Kytezign/USBKVM/mcad/enclosure.FCStd

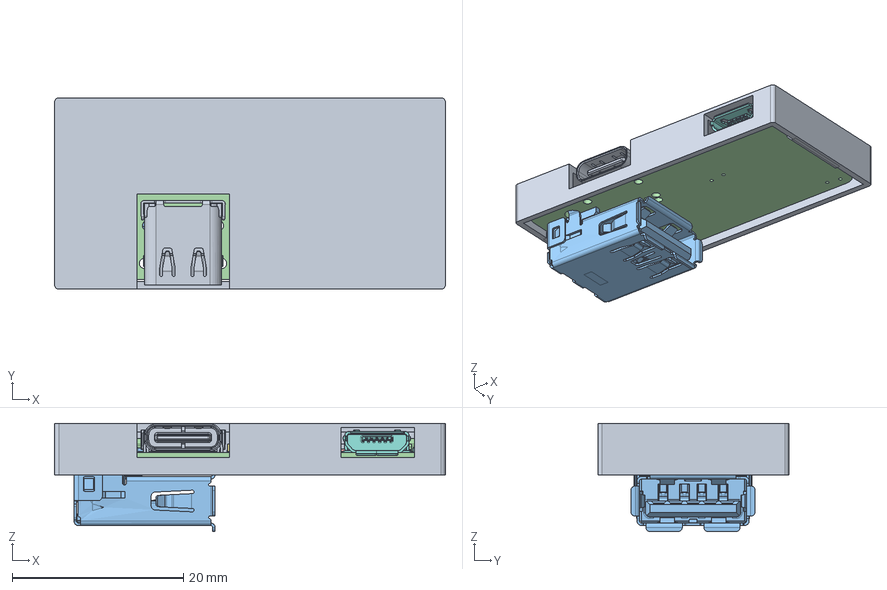
[picture p1: CAD file, 2025-02-08]
mcad/enclosure.FCStd
45.6 x 22.3 x 12.6 mm
ABM8-272-T3
C_0402_1005Metric
C_0402_1005Metric002
C_0402_1005Metric004
C_0402_1005Metric006
QFN_56_1EP_7x7mm_P04mm_EP32x32mm
C_0402_1005Metric008
C_0402_1005Metric010
R_0402_1005Metric
C_0402_1005Metric012
R_0402_1005Metric002
C_0402_1005Metric014
R_0402_1005Metric004
C_0402_1005Metric016
R_0402_1005Metric006
R_0402_1005Metric008
C_0402_1005Metric018
SOT_23_5
R_0402_1005Metric010
C_0402_1005Metric020
R_0402_1005Metric012
C_0402_1005Metric022
C_0402_1005Metric024
C_0402_1005Metric026
C_0402_1005Metric028
R_0402_1005Metric014
R_0402_1005Metric016
C_0402_1005Metric030
R_0402_1005Metric018
C_0402_1005Metric032
QFN_56_1EP_7x7mm_P04mm_EP32x32mm001
C_0402_1005Metric034
C_0402_1005Metric036
SOIC-8-1EP_3.9x4.9mm_P1.27mm_EP2.29x3mm
R_0402_1005Metric020
C_0402_1005Metric038
SOIC-8-1EP_3.9x4.9mm_P1.27mm_EP2.29x3mm002
R_0402_1005Metric022
USB4056-03-A
R_0402_1005Metric024
USB-A3-S-RA
usb_kvm_PCB
