Kytezign/USBKVM/mcad/enclosure-Fusion002.3mf

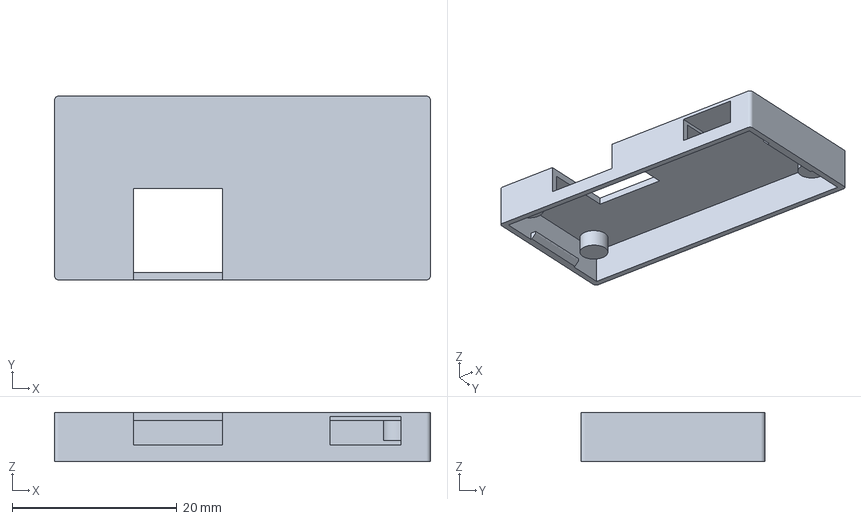
[picture p2: CAD file, 2025-02-08]
mcad/enclosure-Fusion002.3mf
45.6 x 22.3 x 6.00 mm
