Kytezign/USBKVM/ecad/usbkvm/usb_kvm.kicad_pcb

## KiCad design ecad/usbkvm/usb_kvm.kicad_pcb (2025-02-08)

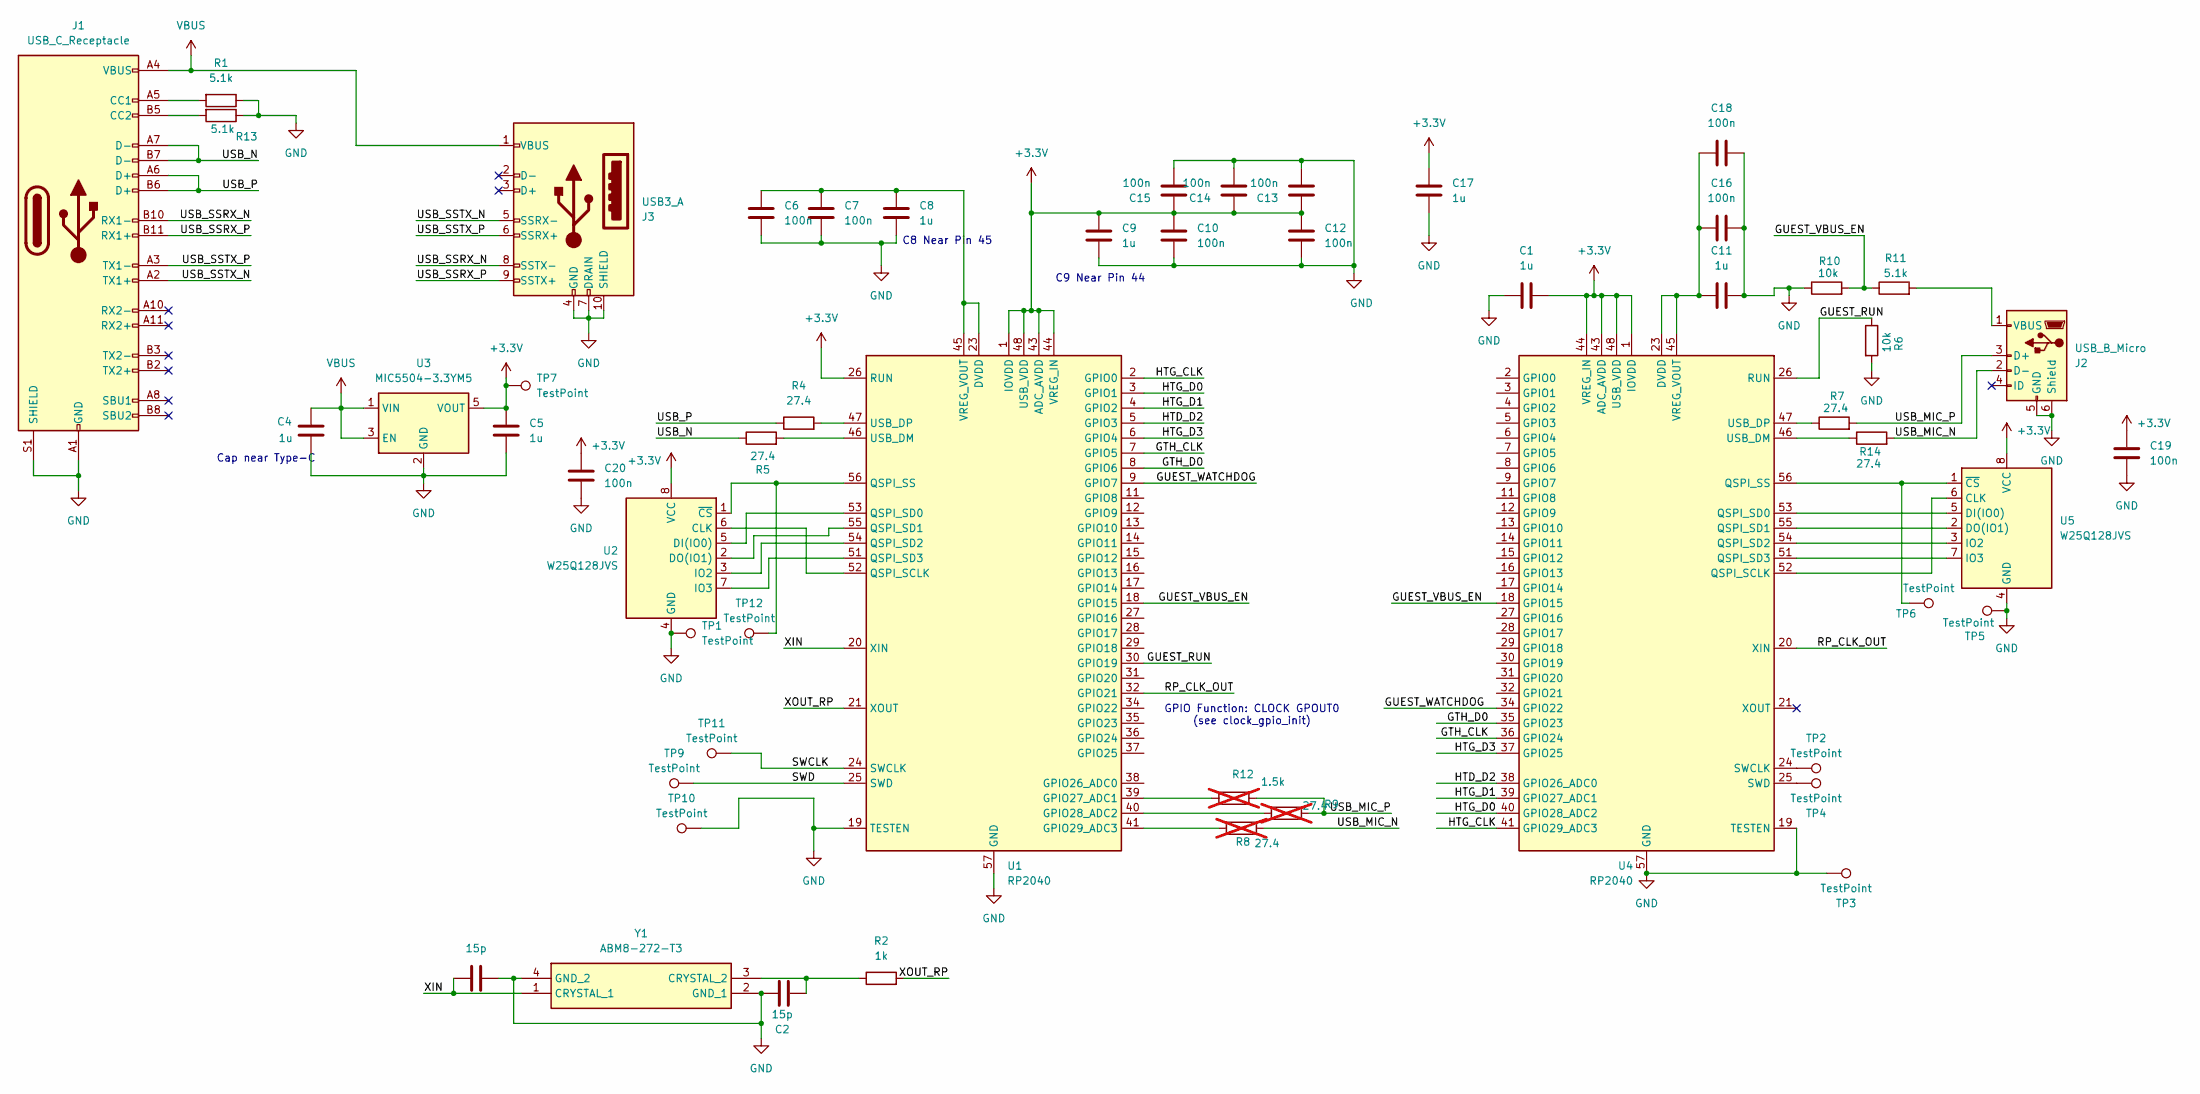
[picture p3: schematic usb_kvm.kicad_sch]

Parts:
C1, C4, C5, C8, C9, C11, C17: 1u; C_0402_1005Metric_Pad0.74x0.62mm_HandSolder
C2, C3: 15p; C_0402_1005Metric_Pad0.74x0.62mm_HandSolder
C6, C7, C10, C12, C13, C14, C15, C16, C18, C19, C20: 100n; C_0402_1005Metric_Pad0.74x0.62mm_HandSolder
J1: USB_C_Receptacle; USB405603A
J2: USB_B_Micro; 101181920001LF
J3: USB3_A; USBA3SRA
R1, R11, R13: 5.1k; R_0402_1005Metric_Pad0.72x0.64mm_HandSolder
R2: 1k; R_0402_1005Metric_Pad0.72x0.64mm_HandSolder
R4, R5, R7, R14: 27.4; R_0402_1005Metric_Pad0.72x0.64mm_HandSolder
R6, R10: 10k; R_0402_1005Metric_Pad0.72x0.64mm_HandSolder
R8, R9: 27.4; R_0402_1005Metric_Pad0.72x0.64mm_HandSolder; not fitted
R12: 1.5k; R_0402_1005Metric_Pad0.72x0.64mm_HandSolder; not fitted
TP1, TP5, TP6, TP7, TP12: TestPoint; TestPoint_THTPad_D1.0mm_Drill0.5mm
TP2, TP3, TP4, TP9, TP10, TP11: TestPoint; TestPoint_Pad_1.5x1.5mm
U1, U4: RP2040; QFN-56-1EP_7x7mm_P0.4mm_EP3.2x3.2mm
U2, U5: W25Q128JVS; SOIC-8_5.23x5.23mm_P1.27mm
U3: MIC5504-3.3YM5; SOT-23-5
Y1: ABM8-272-T3; ABM8272T3; Mouser Part Number 815-ABM8-272-T3

Connections:
+3.3V: C1.2, C5.1, C9.1, C10.1, C12.1, C13.1, C14.1, C15.1, C17.1, C19.1, C20.1, TP7.1, U1.1 (IOVDD), U1.10 (IOVDD), U1.22 (IOVDD), U1.26 (RUN), U1.33 (IOVDD), U1.42 (IOVDD), U1.43 (ADC_AVDD), U1.44 (VREG_IN), U1.48 (USB_VDD), U1.49 (IOVDD), U2.8 (VCC), U3.5 (VOUT), U4.1 (IOVDD), U4.10 (IOVDD), U4.22 (IOVDD), U4.33 (IOVDD), U4.42 (IOVDD), U4.43 (ADC_AVDD), U4.44 (VREG_IN), U4.48 (USB_VDD), U4.49 (IOVDD), U5.8 (VCC)
/GTH_CLK: U1.7 (GPIO5), U4.36 (GPIO24)
/GTH_D0: U1.8 (GPIO6), U4.35 (GPIO23)
/GUEST_RUN: R6.1, U1.30 (GPIO19), U4.26 (RUN)
/GUEST_VBUS_EN: R10.2, R11.1, U1.18 (GPIO15), U4.18 (GPIO15)
/GUEST_WATCHDOG: U1.9 (GPIO7), U4.34 (GPIO22)
/HTD_D2: U1.5 (GPIO3), U4.38 (GPIO26_ADC0)
/HTG_CLK: U1.2 (GPIO0), U4.41 (GPIO29_ADC3)
/HTG_D0: U1.3 (GPIO1), U4.40 (GPIO28_ADC2)
/HTG_D1: U1.4 (GPIO2), U4.39 (GPIO27_ADC1)
/HTG_D3: U1.6 (GPIO4), U4.37 (GPIO25)
/RP_CLK_OUT: U1.32 (GPIO21), U4.20 (XIN)
/SWCLK: TP11.1, U1.24 (SWCLK)
/SWD: TP9.1, U1.25 (SWD)
/USB_MIC_N: J2.2 (D-), R8.1, R14.2
/USB_MIC_P: J2.3 (D+), R7.2, R9.2, R12.2
/USB_N: J1.A7 (D-), J1.B7 (D-), R5.1
/USB_P: J1.A6 (D+), J1.B6 (D+), R4.1
/USB_SSRX_N: J1.B10 (RX1-), J3.8 (SSTX-)
/USB_SSRX_P: J1.B11 (RX1+), J3.9 (SSTX+)
/USB_SSTX_N: J1.A2 (TX1+), J3.5 (SSRX-)
/USB_SSTX_P: J1.A3 (TX1-), J3.6 (SSRX+)
/XIN: C3.1, U1.20 (XIN), Y1.1 (CRYSTAL_1)
/XOUT_RP: R2.2, U1.21 (XOUT)
GND: C1.1, C2.1, C3.2, C4.2, C5.2, C6.2, C7.2, C8.2, C9.2, C10.2, C11.2, C12.2, C13.2, C14.2, C15.2, C16.2, C17.2, C18.2, C19.2, C20.2, J1.A1 (GND), J1.A12 (GND), J1.B1 (GND), J1.B12 (GND), J1.MH3, J1.S1 (SHIELD), J2.5 (GND), J2.6 (Shield), J3.4 (GND), J3.7 (DRAIN), J3.10 (SHIELD), R1.1, R6.2, R10.1, R13.1, TP1.1, TP3.1, TP5.1, TP10.1, U1.19 (TESTEN), U1.57 (GND), U2.4 (GND), U3.2 (GND), U4.19 (TESTEN), U4.57 (GND), U5.4 (GND), Y1.2 (GND_1), Y1.4 (GND_2)
unnamed: J1.A5 (CC1), R1.2
unnamed: J1.B5 (CC2), R13.2
unnamed: J2.1 (VBUS), R11.2
unnamed: R12.1, U1.39 (GPIO27_ADC1)
unnamed: R9.1, U1.40 (GPIO28_ADC2)
unnamed: R8.2, U1.41 (GPIO29_ADC3)
unnamed: U1.52 (QSPI_SCLK), U2.6 (CLK)
unnamed: U1.53 (QSPI_SD0), U2.5 (DI(IO0))
unnamed: U1.55 (QSPI_SD1), U2.2 (DO(IO1))
unnamed: U1.54 (QSPI_SD2), U2.3 (IO2)
unnamed: U1.51 (QSPI_SD3), U2.7 (IO3)
unnamed: TP12.1, U1.56 (QSPI_SS), U2.1 (~CS)
unnamed: R5.2, U1.46 (USB_DM)
unnamed: R4.2, U1.47 (USB_DP)
unnamed: C6.1, C7.1, C8.1, U1.23 (DVDD), U1.45 (VREG_VOUT), U1.50 (DVDD)
unnamed: U4.52 (QSPI_SCLK), U5.6 (CLK)
unnamed: U4.53 (QSPI_SD0), U5.5 (DI(IO0))
unnamed: U4.55 (QSPI_SD1), U5.2 (DO(IO1))
unnamed: U4.54 (QSPI_SD2), U5.3 (IO2)
unnamed: U4.51 (QSPI_SD3), U5.7 (IO3)
unnamed: TP6.1, U4.56 (QSPI_SS), U5.1 (~CS)
unnamed: TP2.1, U4.24 (SWCLK)
unnamed: TP4.1, U4.25 (SWD)
unnamed: R14.1, U4.46 (USB_DM)
unnamed: R7.1, U4.47 (USB_DP)
unnamed: C11.1, C16.1, C18.1, U4.23 (DVDD), U4.45 (VREG_VOUT), U4.50 (DVDD)
unnamed: C2.2, R2.1, Y1.3 (CRYSTAL_2)
VBUS: C4.1, J1.A4 (VBUS), J1.A9 (VBUS), J1.B4 (VBUS), J1.B9 (VBUS), J3.1 (VBUS), U3.1 (VIN), U3.3 (EN)

Notes on the sheet:
C9 Near Pin 44
GPIO Function: CLOCK GPOUT0 (see clock_gpio_init)
Cap near Type-C
C8 Near Pin 45

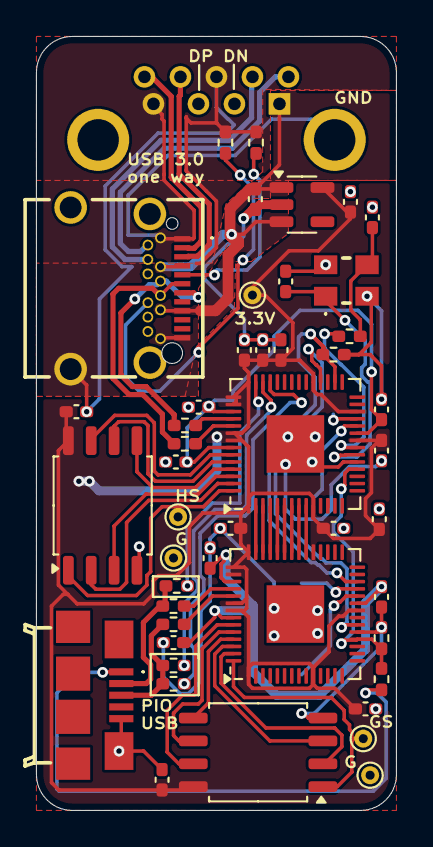
[picture p4: board usb_kvm.kicad_pcb from above]

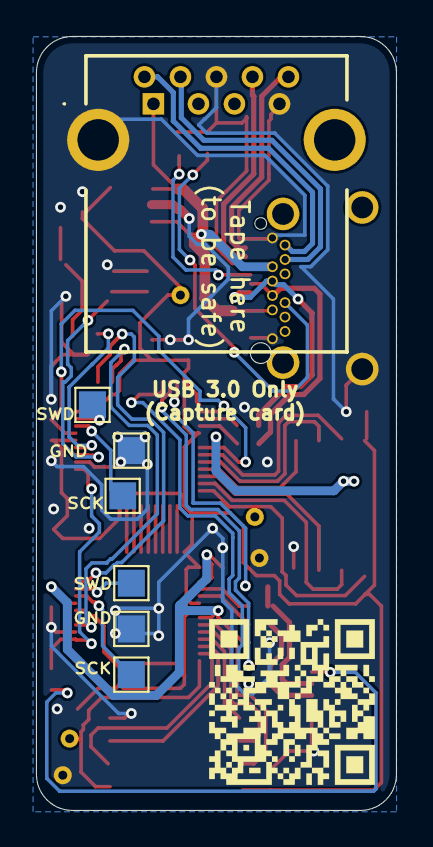
[picture p5: board usb_kvm.kicad_pcb from below]

Board: 2 copper layers, 20.0 x 43.0 mm, 53 parts (7 on the bottom side), 53 nets.
