Kytezign/USBKVM/(commit log)

2024-09-27 Readme Cleanup - also testing github flow
2025-02-08 Good enough to release.
    [10118192-0001LF.stp, ABM8-272-T3.stp, CPC1017N.stp, USB4056-03-A.stp, enclosure-Fusion002.3mf, enclosure.FCStd, rp2040_c0.cfg, usb_kvm.kicad_pcb]
